xiaoensheep/moteus/docs/integration/index.zh-CN.md

# 集成（Integration）

将 moteus 与您的软件和硬件集成。

- [Python 客户端](python.zh-CN.md) - Python 客户端库
- [C++ 客户端](cpp.zh-CN.md) - C++ 客户端库
- [Rust 客户端](rust.zh-CN.md) - Rust 客户端库
- [原始 CAN-FD](can-fd.zh-CN.md) - 直接访问 CAN-FD 协议
- [UART](uart.zh-CN.md) - 逻辑电平 UART 访问

## 主机平台（Host Platforms）

- [Raspberry Pi](../platforms/raspberry-pi.zh-CN.md) - 将 moteus 与 Raspberry Pi 一起使用
- [Nvidia Jetson](../platforms/jetson.zh-CN.md) - 将 moteus 与 Jetson 板卡一起使用
- [socketcan](../platforms/socketcan.zh-CN.md) - Linux SocketCAN 设置
- [Arduino](../platforms/arduino.zh-CN.md) - Arduino 集成
