xiaoensheep/moteus/docs/platforms/index.zh-CN.md

# 主机平台

平台专属的设置指南。

- [Raspberry Pi](raspberry-pi.zh-CN.md) - 在 Raspberry Pi 上使用 moteus
- [Nvidia Jetson](jetson.zh-CN.md) - 在 Jetson 开发板上使用 moteus
- [socketcan](socketcan.zh-CN.md) - Linux SocketCAN 设置
- [Arduino](arduino.zh-CN.md) - Arduino 集成
