xiaoensheep/moteus/docs/protocol/index.zh-CN.md

# 协议参考

底层协议文档。

- [CAN 协议](can.zh-CN.md) - CAN-FD 消息格式
- [寄存器参考](registers.zh-CN.md) - 寄存器映射
- [诊断协议](diagnostic.zh-CN.md) - 诊断命令
