xiaoensheep/moteus/docs/reference/index.zh-CN.md

# 参考

技术参考文档。

- [引脚定义](pinouts.zh-CN.md) - 连接器引脚定义
- [编码器](encoders.zh-CN.md) - 支持的编码器
- [客户端工具](client-tools.zh-CN.md) - moteus_tool 和 tview
- [配置参数](configuration.zh-CN.md) - 所有配置参数
- [硬件规格](hardware.zh-CN.md) - 硬件规格
- [烧录与构建固件](firmware.zh-CN.md) - 固件详情
- [应用限制](limits.zh-CN.md) - 运行限制
- [工作原理](theory.zh-CN.md) - 控制理论背景

## API 参考

- [Python API](python.zh-CN.md) - Python API 参考

## 协议

- [CAN 协议](../protocol/can.zh-CN.md) - CAN-FD 消息格式
- [寄存器参考](../protocol/registers.zh-CN.md) - 寄存器映射
- [诊断协议](../protocol/diagnostic.zh-CN.md) - 诊断命令
