xiaoensheep/moteus/docs/guides/index.zh-CN.md

# 使用 moteus（Using moteus）

用于设置和使用 moteus 的分步指南。

- [机械设置](mechanical-setup.zh-CN.md) - 物理安装
- [电气设置](electrical-setup.zh-CN.md) - 布线与电源连接
- [软件安装](software-installation.zh-CN.md) - 安装客户端软件
- [配置](configuration.zh-CN.md) - 基本配置
- [编码器概述](encoder-overview.zh-CN.md) - 了解编码器选项
- [校准](calibration.zh-CN.md) - 电机校准过程
- [PID 整定](pid-tuning.zh-CN.md) - 整定位置与速度控制
- [控制模式](control-modes.zh-CN.md) - 位置、速度和转矩模式

## 高级配置

- [带霍尔效应的电机](hall-effects.zh-CN.md) - 使用霍尔效应传感器
- [双编码器](dual-encoders.zh-CN.md) - 独立的电机与输出编码器
