xiaoensheep/moteus/docs/guides/optimizing-for-max-duty-cycle.zh-CN.md

# 优化最大占空比（Optimizing for maximum duty cycle）

## 背景

在某些情况下，moteus 能否在不借助弱磁的情况下在给定电机上达到尽可能高的转速非常重要。控制器在可将多少电源电压施加到电机上是有限制的。根据定义，它所能提供的倍数是小于 1 的。该倍数受限于 moteus 为了执行磁场定向控制（FOC）而必须能够传感流向电机的电流这一要求。有两个因素制约着这一限制：

1. 只有在“低侧”MOSFET 导通时才能传感电流。因此，低侧 MOSFET 导通的时间必须足够长，以使 ADC 触发并完成其采样过程。
2. ADC 的输入是 moteus 板载的电流检测放大器（CSA）。该放大器具有与增益相关的建立时间，必须予以遵守。该建立时间必须在 ADC 采样过程开始*之前*完成。

## 整定参数

为了最大化可用占空比，有两个参数可以控制。

1. `servo.pwm_rate_hz`：PWM 速率越低，可用占空比越高。将其设为最小值 15000 Hz 即为极限。较低的 PWM 速率会降低控制更新速率，并降低电路板可支持的峰值功率。

2. `drv8323.csa_gain`：电流检测放大器增益，可以是 [5, 10, 20, 40] 之一。默认值为 20。将其降低到 10 可获得最大的占空比收益，代价是电流检测噪声增加。这会导致系统发出更多可闻噪声，并降低可用的转矩控制带宽。
