xiaoensheep/moteus/docs/troubleshooting/gate-driver-faults.zh-CN.md

# 门极驱动器故障排查

moteus 中某些类型的电气问题会导致板载 MOSFET 门极驱动器（gate driver）报告错误状态。发生这种情况时，moteus 会报告故障（fault）33。本文档描述了如何排查此问题。

## 确定原因

要确定门极驱动器标记的是\*哪个\*故障，你需要在 tview 中查看 `drv8323` 树，或使用 `python -m moteus.moteus_tool -t 1 --read drv8323`。每个故障都有一个与之关联的不同布尔值，并且可能同时标记多个故障。不过从诊断的角度来看，它们归结为两类：

## 可恢复的故障

唯一在重复出现时也容易恢复的故障类型是 `uvlo=true` 故障。这意味着门极驱动器检测到输入电源电压降到了最低工作阈值以下。当 moteus 试图从电源或电池吸取超过其所能提供的功率时，就会发生这种情况。根据原因的不同，有几种潜在的解决办法：

**moteus 需要输出更大的转矩/功率**：如果故障触发了，但 moteus 尚未为你的应用施加足够的转矩，那么你必须更换电源以提供更多功率。如果电源是限流的实验室电源，你可以提高电流限制。如果是固定电流的壁挂式电源，你可以换成输出功率更高的电源。如果是电池，你可以换成峰值电流额定值更高的电池。也可能是因为电源布线不良，即电源电缆的电阻过高所致。

**moteus 本不应试图吸取那么多功率**：如果 moteus 试图施加的转矩或功率超过了期望值，有两个可以调整的限制。

1. `servo.max_current_A` - 它决定了 moteus 能够输出的最大相电流（current），并对应于它能输出的最大转矩。这与电源功率并不直接相关，因为所需的电源功率还与电机速度（velocity）成线性关系。不过，最好确保它没有被设置得比实际需要更大。
2. `servo.max_power_W` - 它决定了 moteus 能够向电机输出的最大功率，因此也大致决定了它所能消耗的电源功率。如果使用的电源具有已知的电压和电流能力，你可以将其设置为该功率的一部分，以留出足够的裕量。

## 不可恢复的故障

门极驱动器报告的大多数非 uvlo 故障都表明控制器遭受了电气损坏。大多数原因在用户指南的电气部分中列出：

- [使用 moteus：电气部分](../guides/electrical-setup.zh-CN.md)

也就是说，不良的导线制作会导致微电弧（micro-arcing），进而可能在电源端子或电机相端子上产生较大的电压瞬变。缺乏浪涌电流（inrush current）管理也会在电源端子上产生较大的电压瞬变。XT30 连接器的应力释放不良同样会导致微电弧和较大的电压瞬变。

在这些情况下，或许可以通过更换元器件来修复控制器，但这需要中等到高级的 SMT 返修能力，超出大多数用户的能力范围。通常恰当的做法是：确定哪些电气安装指南没有被遵守，纠正这些问题，然后用新的控制器替换。
