xiaoensheep/moteus/docs/troubleshooting/index.zh-CN.md

# 故障排查

moteus 控制器的常见问题及解决方案。

- [校准问题](calibration.zh-CN.md) - 电机校准期间的问题
- [无运动](no-motion.zh-CN.md) - 电机不响应命令
- [转矩受限](limited-torque.zh-CN.md) - 电机无法达到预期的转矩
- [门极驱动器故障](gate-driver-faults.zh-CN.md) - DRV8323 故障码
- [超时模式 11](timeout-mode-11.zh-CN.md) - 通信超时错误
- [过压故障 34](overvoltage-fault-34.zh-CN.md) - 再生制动问题
