xiaoensheep/moteus/(list of files, drawings)

Other design files:
hw/n1/ad/Imported moteus_n1.PrjPcb/moteus_n1.PcbDoc
hw/n1/ad/Imported moteus_n1.PrjPcb/moteus_n1.PCBLIB
hw/n1/ad/Imported moteus_n1.PrjPcb/moteus_n1.PrjPcb
hw/n1/ad/Imported moteus_n1.PrjPcb/moteus_n1.SchDoc
hw/n1/ad/Imported moteus_n1.PrjPcb/moteus_n1.SCHLIB
